HOLYNOTBAD/holydrone/docs/DIRECTORIES.md

# 目录索引

核查日期：2026-10-18。以下逐目录列出当前仓库内容；不含 Git 内部目录和会话锁文件。文件数不是采购数量。

| 路径 | 内容 | 直接文件数（不含锁文件） |
| --- | --- | --- |
| `3dp4drone/` | 机载打印件及其 CAD 原稿、材料库。 | 1 |
| `3dp4drone/balloonstatictowing/` | 静态牵引支架、气球托、衬套、碳棒示意和说明。 | 7 |
| `3dp4drone/balloontowing/` | 可转动拖曳机构与共享气球包络。 | 9 |
| `3dp4drone/balloontowing/STL_打印件/` | 仅 05/30/31/32 四个当前打印件。 | 4 |
| `3dp4drone/batteryholder/` | 共用电池托。 | 2 |
| `3dp4drone/camholder/` | 0/30/90°相机支架与网格变体。 | 8 |
| `3dp4drone/nxholder/` | NX 原支架、鲁班猫改装支架和孔位验证。 | 18 |
| `3dp4drone/receiver/` | 接收模块支架原稿与改装变体。 | 5 |
| `3dp4drone/rtk-ant holder/` | RTK 天线支架。 | 2 |
| `3dp4drone/side plate/` | 侧板和扩展模块安装板。 | 6 |
| `3dp4exp/` | 地面实验附件，非飞行器主机型。 | 0 |
| `3dp4exp/balloon dynamic holder/` | 当前为空目录，未提供可用动态气球固定模型。 | 0 |
| `3dp4exp/balloon static holder/` | 地面气球固定附件。 | 2 |
| `3dp4exp/drone takeoff stand/` | 起飞支撑件。 | 4 |
| `3dp4exp/RTK base station/` | 基站三件 STL。 | 3 |
| `demo/` | 原始爆炸视图参考视频。 | 1 |
| `docs/` | 公开说明、来源与核查记录。 | 3 |
| `docs/data/` | 配置清单、几何快照、媒体哈希与验证记录。 | 4 |
| `docs/history/` | 整理前说明的读取文本快照，保留旧路径与历史修复记录，不是有效 CAD 机型。 | 1 |
| `docs/media/` | README 展示 GIF、静态预览及素材说明。 | 7 |
| `docs/tools/` | 按 PID 连接、只读导出 CAD 网格与渲染 GIF 的脚本及说明。 | 5 |
| `fasteners/` | 紧固件外形及组合/镜像模型。 | 29 |
| `modules/` | 采购模块外形与派生装配模型。 | 8 |
| `modules/LubanCat4/` | 鲁班猫原始 STEP 及带/不带底板的派生模型。 | 3 |
| `modules/misc/` | 输入交换格式与下载来源包；其中也有主装配有效依赖。 | 6 |
| `modules/misc/antenna-sma-915-mhz-for-lara-1.snapshot.2/` | 天线 STEP/FreeCAD 原文件及截图。 | 3 |
| `modules/misc/C-RTK 2hp/` | C-RTK2Hp 原始 STEP 与有效 SLDPRT 依赖。 | 2 |
| `modules/misc/gxivision-s2m06-1.snapshot.6/` | 相机 CAD 下载快照与截图。 | 4 |
| `modules/misc/lipo-battery-2.snapshot.2/` | 电池子装配、叶子零件、渲染和贴图；有效依赖。 | 7 |
| `modules/misc/propeller-622.snapshot.2/` | 桨叶 STEP 与截图。 | 2 |
| `modules/misc/speedybee-f405-mini-bls-35a-1.snapshot.4/` | 飞控/电调原始 STEP、SLDPRT 与截图。 | 4 |
| `modules/misc/telemetry-cuav-air-link-4g-1.snapshot.3/` | Air Link 4G 原始多格式模型，当前主机型清单未启用。 | 4 |
| `plates/` | 机架板件 CAD。 | 8 |
