HOLYNOTBAD/holydrone/docs/SOURCES.md

# 来源、核查范围与待确认事项

日期：2026-10-18。此文件说明公开文档每类结论的证据边界，不把旧聊天记录或旧路径当作当前磁盘状态。

旧说明的读取文本保存在 [整理前说明快照](history/20261018-notes-before-update.txt)，包括旧路径、安装坐标与历史修复记录；只用于追溯，不作为当前生产依据。

## 已读取的仓库证据

| 来源 | 支持的内容 | 限制 |
| --- | --- | --- |
| 四个根目录主装配体 | 配置名、组件路径、压缩/可见状态、零件几何与变换 | 用 SolidWorks 2024 独立只读会话读取，未保存 CAD；不等于完成配合求解、全机碰撞或实物验证 |
| `装配版本说明.txt` | NX/鲁班猫/拖曳版本的建模历史 | 原文旧路径已按本次实际组件清单更正；历史修复记录不是本次验证结果 |
| `3dp4drone/nxholder/鲁班猫支架安装说明.txt`、`tray6_validation.txt` | 六孔支架接口、USB 朝向、底板保留与既有孔位验证 | 本次核对启用模型，未重做全部孔轴、流形、强度与打印工艺验证 |
| 两个牵引目录内说明 | 打印件用途、静态版尺寸与建模历史 | 已更正“气球未建模”、旧目录、旧暂定规格表述；采购件和制造工艺缺项仍待确认 |
| `modules/misc/` 与 `modules/LubanCat4/` 输入文件 | 外部输入 CAD 的文件级线索 | `snapshot` 文件夹名不能确定平台、作者或授权，不编造 GrabCAD 等下载链接 |
| `demo/holydrone explode.mp4` | 真实爆炸展示参考的分层展开方式 | 原片本身不能证明四种当前机型状态；新 GIF 分别读取 NX/鲁班猫实际几何 |
| 仓库六张原有 PNG/JPG | 逐张检查为天线截图、相机渲染、电池渲染/贴图、桨叶截图、飞控渲染 | 不是两种牵引版的整机实物照片；电池贴图上的标签不作为本机采购规格 |
| 维护者直接提供的规格 | 静态碳棒直径 4 mm、长度 300 mm | 本次 CAD 包围盒与之相符；没有实物测量照片或采购凭证 |

根目录检查未发现适用的 `AGENTS.md`；核查过从磁盘根目录至仓库的祖先目录及仓库内部。初始 Git 状态已有大量修改、删除、未跟踪文件，整理未覆盖或撤销这些 CAD 改动，也未提交/推送。

## CAD 配置检查

| 装配体 | 配置 | 启用组件条目数（含子装配及叶子） | 缺失的启用路径 |
| --- | --- | ---: | ---: |
| NX | 默认 | 61 | 0 |
| 鲁班猫 | 默认 | 61 | 0 |
| 静态牵引 | STATIC_TOWING_NOHOST | 63 | 0 |
| 拖曳 | GROUND_0deg | 57 | 0 |
| 拖曳 | AIRBORNE_90deg | 58 | 0 |

明细见 [assembly-components.tsv](data/assembly-components.tsv)。压缩状态原始值 `0` 为压缩，本次 `2` 为已解析；`hidden` 是包含父级状态的可见性结果。条目数包含子装配和叶子，不能作为实物件数相加。已压缩组件的缺失不在上表“启用路径”统计范围内。

`geometry-snapshot.json` 记录保存配置读取时的零件局部包围盒（米）和 SolidWorks 变换。两牵引版球体局部范围为 ±0.075 m；静态碳棒为 0.004×0.004×0.300 m；这些是 CAD 几何证据。

打开四个主装配体时错误码均为 0、警告码 32（swFileLoadWarning_NeedsRegen，需要重建）。初次提取时四份文档 `GetSaveFlag=False`；遍历并还原配置后拖曳装配在内存中 `GetSaveFlag=True`。本次未执行完整重建/配合修复，也未调用任何 CAD 保存接口；开源使用前需在工作副本中重建并核查警告。修改标记只属于专用只读会话，未据此覆盖磁盘。

## Notion 访问与待补摘要

指定页面：[holydrone 7](https://app.notion.com/p/holydrone-7-3573520427fd8005840cdcc12764cd68)。2026-10-18 在浏览器实际打开后显示“登录即可在 Hong Li 的工作空间中查看此页面”。当前没有可读正文；未绕过权限，也未把空白 HTML 壳当作页面内容。

需要由有权限的账号登录、提供公开只读页面，或导出包含正文及图片的页面资料。访问条件已在整理开始阶段告知用户。待访问后逐项补齐：

- BOM：实际品牌、版本、数量、购买来源、电池及动力规格；与装配模型差异。
- 设计方案：页面所述目标、方案选择依据与实验结构，区分历史方案和当前四机型。
- 性能：实测重量、载荷、续航、定位/牵引表现及测试条件；没有数据则保持未测。
- 调试：接线图、固件版本、参数文件、接口映射、标定流程、日志与已知问题。
- 展示：静态/可转动牵引版实物照片、拍摄来源与可公开使用的授权。

根 README 中相应段落是仓库证据整理，不是对尚不可读 Notion 页面的摘要。

## 第三方模型与许可追溯

| 输入线索 | 已知元数据 | 仍需补充 |
| --- | --- | --- |
| `LubanCat 4.STEP`、`C-RTK2Hp.STEP` | STEP 头部记录 SolidWorks 2021，作者/组织为空 | 原始发布者、下载页、版本、模型许可 |
| `ORIN NX.stp` | STEP author 字段为 `INVENTOR` | 实际作者、硬件厂商及载板版本、下载页与授权；工具名不能作署名 |
| 天线 STEP / FCStd | STEP 头部为 FreeCAD / Open CASCADE，作者为空 | 模型作者和许可；格式/工具不证明权属 |
| `Telemetry CUAV Air Link 4G.stp` | CATIA V5 导出，author/organization 为 `none` | 原始来源与许可；当前主机型清单未启用此 4G 模型 |
| 相机/飞控/桨叶 `snapshot` 包 | 保留下载包名、交换格式和截图 | 真实下载链接、原作者及适用条款；不能据文件夹猜测平台 |
| NX 支架/接收支架 CATPart 原稿 | 保留原稿和后续 SLDPRT/STL | 原设计者、转换/改装关系、是否允许再分发与改装 |
| 机架板件/电机/紧固件等 | 模型名称与当前装配引用 | 原始设计/下载来源、图纸权利、实际采购记录 |

仓库未发现 LICENSE/COPYING 等明确授权文件，本次未添加任何许可证。公开可访问不等于自由授权；应由权利人确认项目代码/文档/自制件的许可，并独立核实第三方 CAD 是否可随仓库再分发。

## 本次修改边界

新增中文 README、零件来源表、目录索引、配置/几何/哈希记录、两份 GIF 与四份 PNG、动画生成脚本、锁文件忽略规则；修正三份旧说明。未修改 CAD/STL、未重命名零件、未删除归档数据、未提交推送或发布。历史归档和缺失外部来源均明确标记，不列成当前有效机型或采购依据。
