HOLYNOTBAD/holydrone/demo/holydrone_lbc4_v1-exploded.png

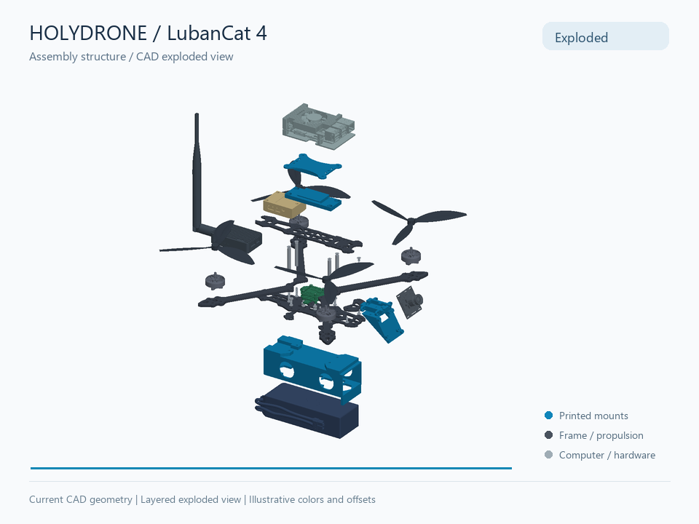
demo/holydrone_lbc4_v1-exploded.png
