HOLYNOTBAD/holydrone/demo/real/originals/holydrone_lbc4.jpg

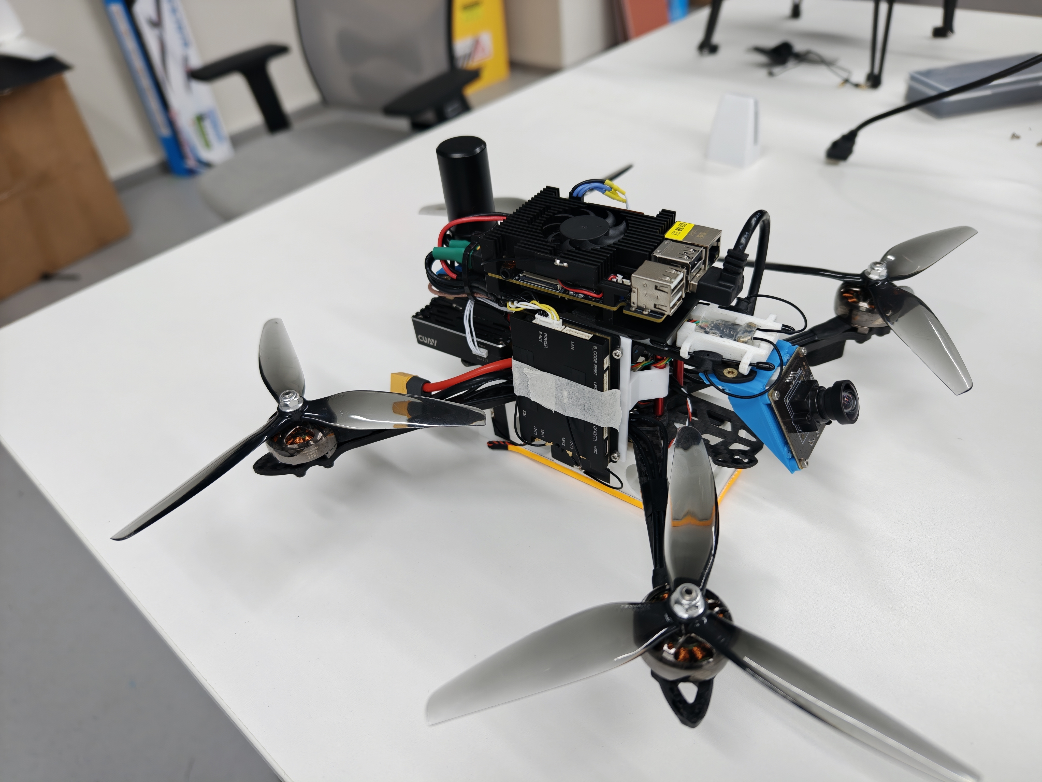
demo/real/originals/holydrone_lbc4.jpg
