HOLYNOTBAD/holydrone/demo/real/originals/holydrone_nx.png

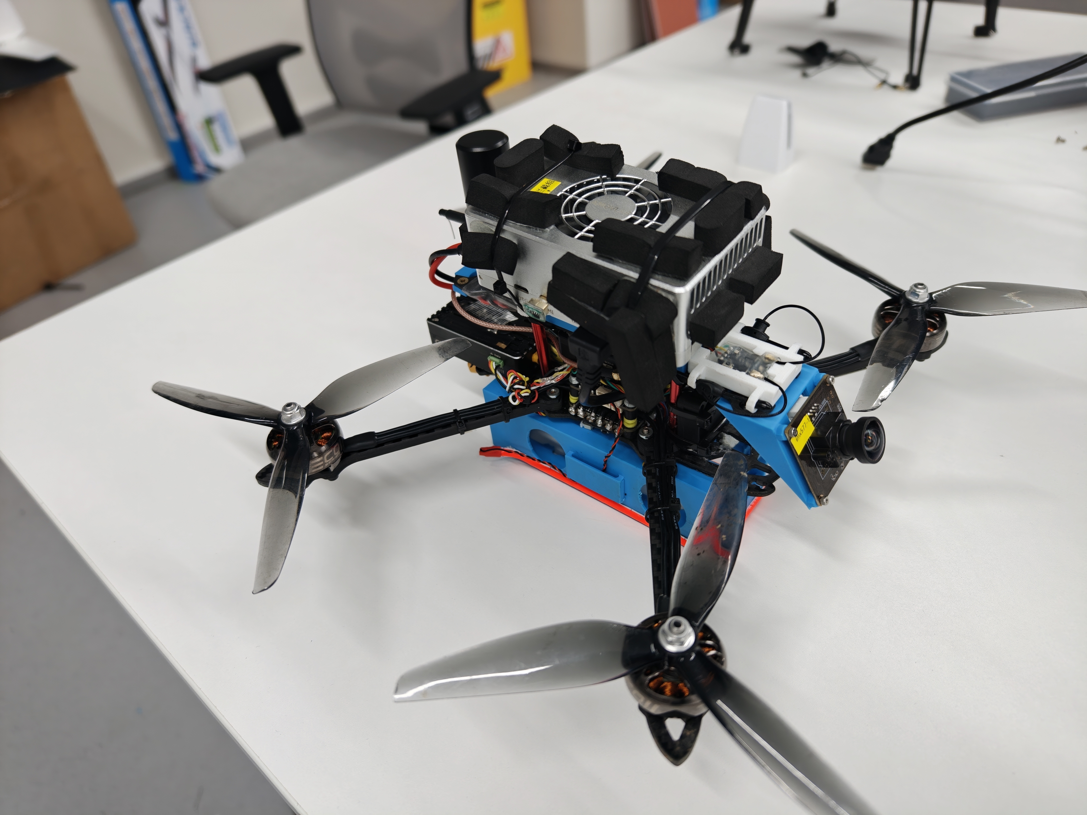
demo/real/originals/holydrone_nx.png
