HOLYNOTBAD/holydrone/demo/real/originals/holydrone_nx_darkbg.jpg

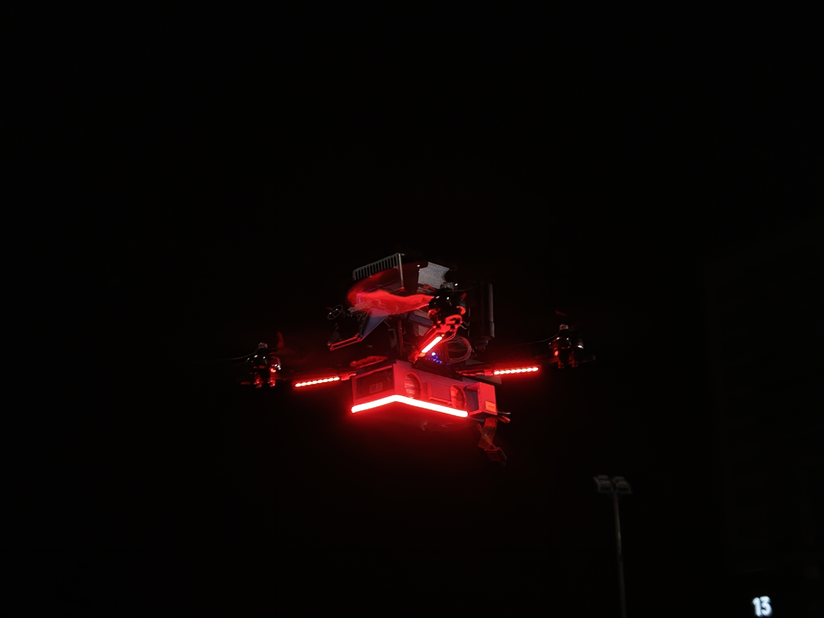
demo/real/originals/holydrone_nx_darkbg.jpg
