HOLYNOTBAD/holydrone/demo/real/originals/holydrone_static_towing.jpg

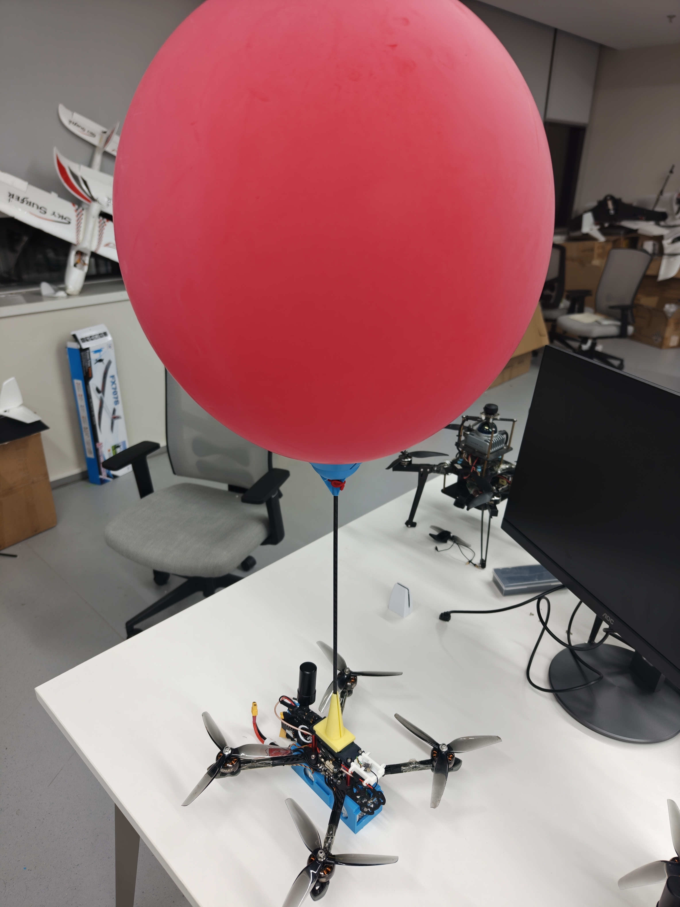
demo/real/originals/holydrone_static_towing.jpg
