HOLYNOTBAD/holydrone/Hardware/modules/misc/gxivision-s2m06-1.snapshot.6/Captura de tela 2026-01-26 100149.png

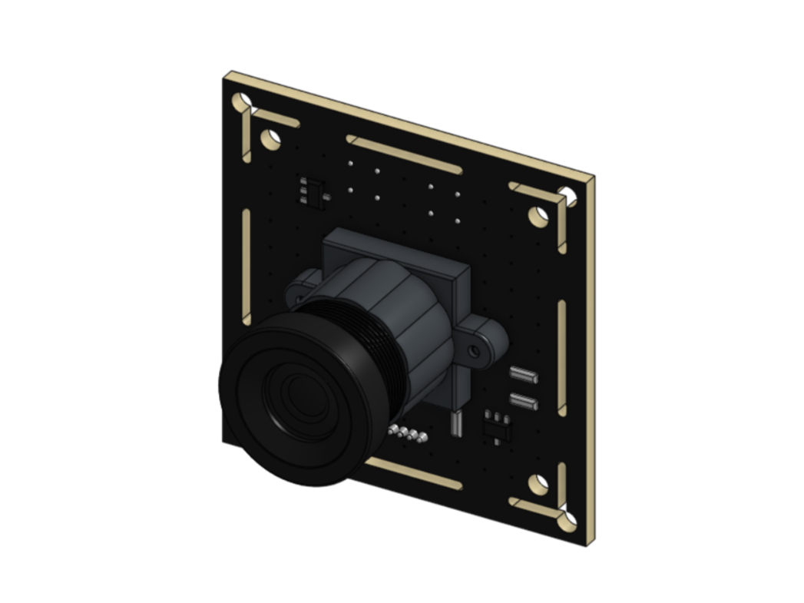
Hardware/modules/misc/gxivision-s2m06-1.snapshot.6/Captura de tela 2026-01-26 100149.png
