HOLYNOTBAD/holydrone/Hardware/modules/misc/lipo-battery-2.snapshot.2/s-l1600.png

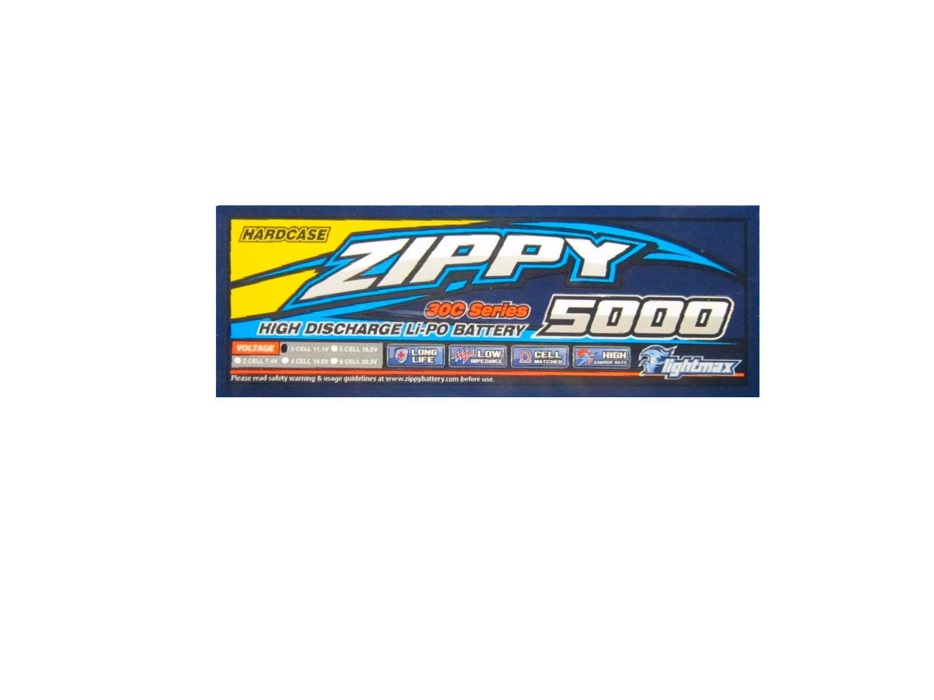
Hardware/modules/misc/lipo-battery-2.snapshot.2/s-l1600.png
