HOLYNOTBAD/holydrone/Hardware/modules/misc/propeller-622.snapshot.2/Знімок екрана 2025-10-03 111559.png

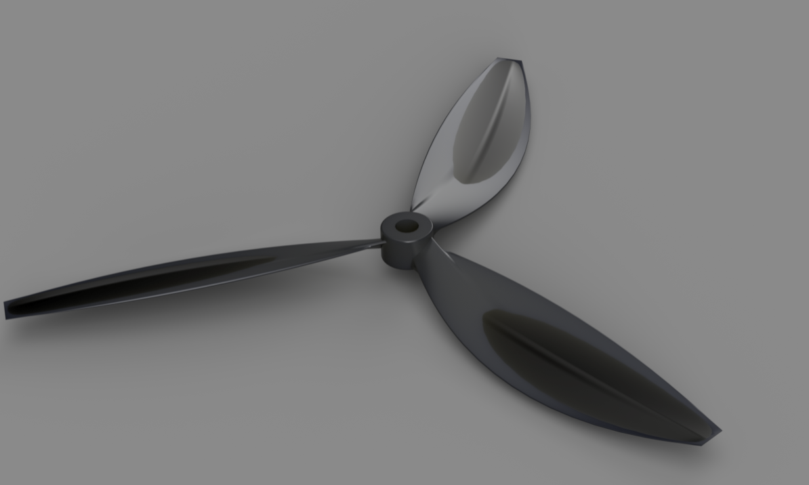
Hardware/modules/misc/propeller-622.snapshot.2/Знімок екрана 2025-10-03 111559.png
