HOLYNOTBAD/holydrone/Hardware/modules/misc/speedybee-f405-mini-bls-35a-1.snapshot.4/Captura de tela 2026-01-25 144755.png

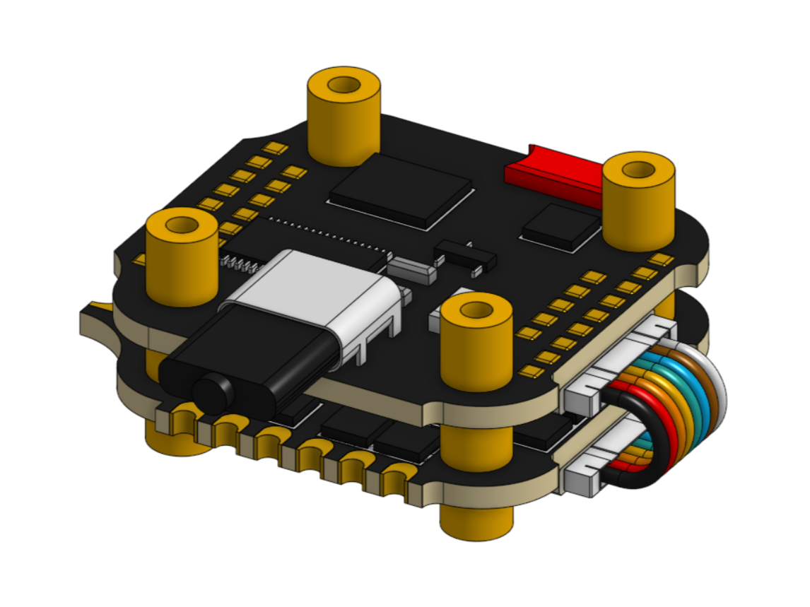
Hardware/modules/misc/speedybee-f405-mini-bls-35a-1.snapshot.4/Captura de tela 2026-01-25 144755.png
