HOLYNOTBAD/holydrone/modules/misc/antenna-sma-915-mhz-for-lara-1.snapshot.2/2025-11-23_17-32.jpg

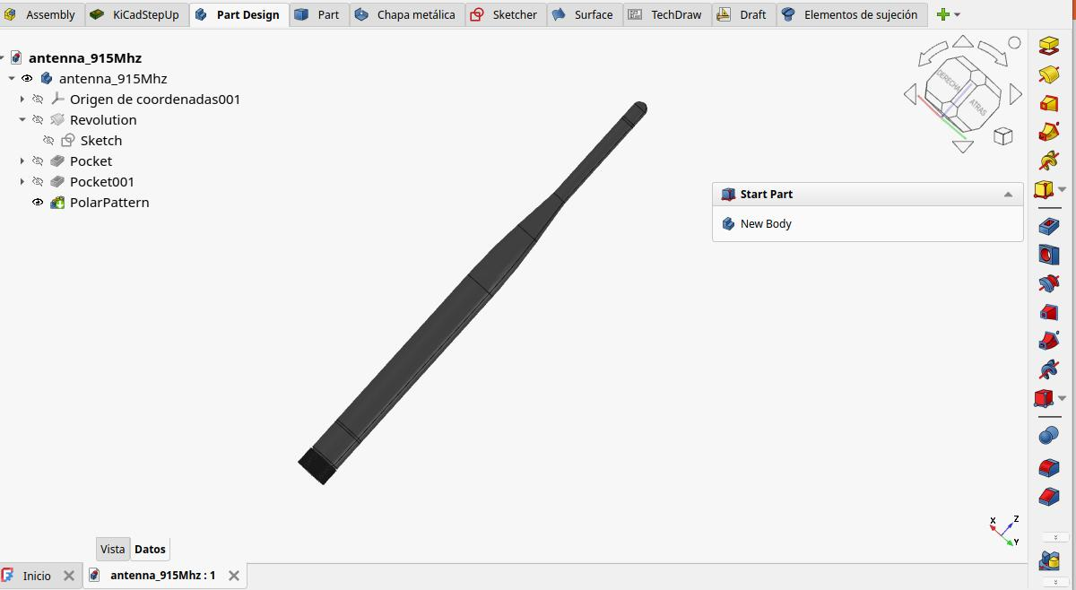
modules/misc/antenna-sma-915-mhz-for-lara-1.snapshot.2/2025-11-23_17-32.jpg
