HOLYNOTBAD/holydrone/modules/misc/lipo-battery-2.snapshot.2/renderizado.jpg

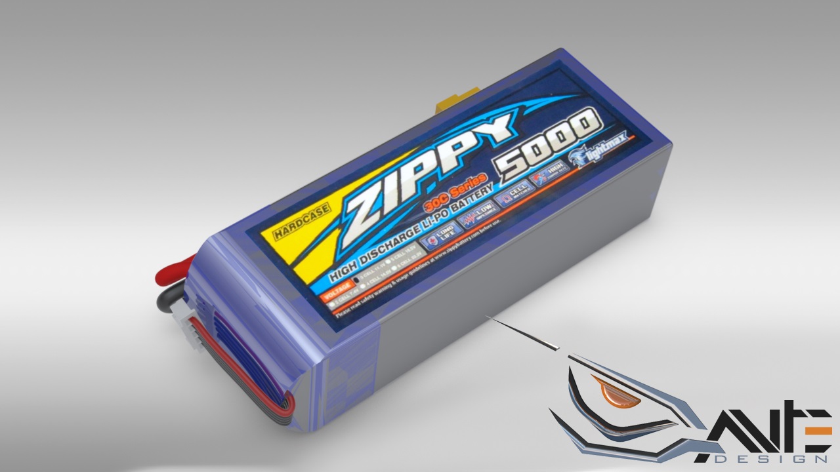
modules/misc/lipo-battery-2.snapshot.2/renderizado.jpg
