HOLYNOTBAD/holydrone/demo/bom/README.md

# BOM image sources

Original product images were retrieved from the authorized Notion BOM entries on October 19, 2026 and saved unchanged. The source pages are private and require access permission.

| BOM item | Image | Source |
| --- | --- | --- |
| 1 | [01-mark4-frame.png](01-mark4-frame.png) | [Notion entry](https://app.notion.com/p/3853520427fd80eb8708d67b02aa0914) |
| 2 | [02-emax-2807-motor.png](02-emax-2807-motor.png) | [Notion entry](https://app.notion.com/p/3853520427fd80c997d2fe212cc42cc3) |
| 3 | [03-micoair743-v2-stack.png](03-micoair743-v2-stack.png) | [Notion entry](https://app.notion.com/p/3863520427fd80e5b3b5d1053c863097) |
| 4 | [04-allspark2-orin.png](04-allspark2-orin.png) | [Notion entry](https://app.notion.com/p/3863520427fd80f0aee0de7d13960a08) |
| 5 | [05-cuav-p9-radio.png](05-cuav-p9-radio.png) | [Notion entry](https://app.notion.com/p/3863520427fd8081b237eaf9323663f4) |
| 6 | [06-elrs-receiver.png](06-elrs-receiver.png) | [Notion entry](https://app.notion.com/p/3863520427fd8022b8f5facd52861a36) |
| 7 | [07-usb-camera.png](07-usb-camera.png) | [Notion entry](https://app.notion.com/p/3863520427fd80dabec5fc4ffb251a3b) |
| 8 | [08-unnamed-item.png](08-unnamed-item.png) | [Notion entry](https://app.notion.com/p/39c3520427fd80ab800af4c0dd67ad9f) |
| 9 | [09-hqprop-7040.png](09-hqprop-7040.png) | [Notion entry](https://app.notion.com/p/3863520427fd80a888f2d6b08ec50436) |
| 10 | [10-dc-dc-converter.png](10-dc-dc-converter.png) | [Notion entry](https://app.notion.com/p/3863520427fd803482f5eda7833b36de) |
| 12 | [12-display-emulator.png](12-display-emulator.png) | [Notion entry](https://app.notion.com/p/3863520427fd8089b535e494862bcd4c) |
| 14 | [14-parachute.png](14-parachute.png) | [Notion entry](https://app.notion.com/p/3893520427fd8031a077c74d3382d327) |
| 15 | [15-cuav-rtk.png](15-cuav-rtk.png) | [Notion entry](https://app.notion.com/p/3893520427fd804b8ea0cf309360ff4a) |
| 11 | [10-dc-dc-converter.png](10-dc-dc-converter.png) | [Notion entry](https://app.notion.com/p/3863520427fd803482f5eda7833b36de); generic image shared with the 12 V entry; the 5 V entry has no image |

Item 13 (RGB LED strip and quick-connect board) has no source image. Item 8 has no name; its image advertises a USB industrial camera, but the model remains unconfirmed. The 5 V converter shares a generic product image with the 12 V entry. Product images identify appearance and do not independently verify advertised performance.
