HOLYNOTBAD/holydrone/(list of files, cad)

Other CAD files:
Hardware/Hardware.SLDASM
Hardware/modules/misc/lipo-battery-2.snapshot.2/Bateria Lipo.SLDASM
holydrone_nx_v1.SLDASM
Hardware.SLDASM
Hardware/holydrone_towing_v1.SLDASM
Hardware/holydrone_lbc4_v1.SLDASM
holydrone_v1.SLDASM
Hardware/holydrone_static_towing_v1.sldasm
holydrone_v1_NoProp.SLDASM
modules/CUAV P9 Radio.SLDASM
modules/misc/lipo-battery-2.snapshot.2/Bateria Lipo.SLDASM
3dp4drone/balloonstatictowing/static_carbon_rod_D4_L300_assumed.SLDPRT
3dp4drone/balloontowing/32_BatteryHolder_MountReady.SLDPRT
3dp4drone/balloontowing/STL_打印件/05_Balloon50_QuickTie_Ballast.stl
3dp4drone/batteryholder/batteryholder v9.sldprt
3dp4drone/camholder/camholder30deg.SLDPRT
3dp4drone/nxholder/nxholder_Part2-rk3588lbc4.STEP
3dp4drone/receiver/receiver_Part1_org.SLDPRT
3dp4drone/rtk-ant holder/rtk-ant holder.SLDPRT
3dp4drone/side plate/Side 5GmodulePlate.SLDPRT
3dp4exp/balloon static holder/balloon static holder.SLDPRT
3dp4exp/drone takeoff stand/support.SLDPRT
camholder/camhold.stl
Hardware/3dp4drone/balloonstatictowing/气球托v4 4.2mm.STL
Hardware/3dp4drone/balloontowing/11_Balloon_D50_Envelope.SLDPRT
Hardware/3dp4drone/balloontowing/STL_打印件/31_Clamp_Rounded.stl
Hardware/3dp4drone/camholder/camholder0deg.SLDPRT
Hardware/3dp4drone/nxholder/up nxholder.stl
Hardware/3dp4drone/receiver/receiver_Part1.SLDPRT
Hardware/3dp4drone/rtk-ant holder/rtk-ant holder.STL
Hardware/3dp4drone/side plate/Side Plate.SLDPRT
Hardware/3dp4exp/balloon static holder/balloon static holder.STL
Hardware/3dp4exp/drone takeoff stand/support30degree.SLDPRT
Hardware/3dp4exp/RTK base station/RTK base station prt2.stl
Hardware/modules/C-RTK2Hp.SLDPRT
Hardware/modules/LubanCat4/LubanCat4_with_bottom_tray.SLDPRT
Hardware/modules/misc/antenna-sma-915-mhz-for-lara-1.snapshot.2/antenna_915Mhz.FCStd
Hardware/modules/misc/gxivision-s2m06-1.snapshot.6/Câmera GXIVISION S2M06.sldprt
Hardware/modules/misc/Telemetry CUAV Air Link 4G.stp
Hardware/plates/TailPlate.SLDPRT
modules/LubanCat4/LubanCat4_no_bottom_tray.SLDPRT
modules/misc/C-RTK 2hp/C-RTK2Hp.STEP
modules/misc/gxivision-s2m06-1.snapshot.6/Câmera GXIVISION S2M06.step
modules/misc/lipo-battery-2.snapshot.2/Conector XT60.SLDPRT
modules/misc/speedybee-f405-mini-bls-35a-1.snapshot.4/SpeedyBee F405 Mini BLS 35A.step
modules/misc/Telemetry CUAV P9 radio.SLDPRT
modules/misc/telemetry-cuav-air-link-4g-1.snapshot.3/Telemetry CUAV Air Link 4G.SLDPRT
modules/Propeller 7inch.SLDPRT
others/Battery Pad.SLDPRT
plates/ChinPlate.SLDPRT
Simulation/holydrone_sim/gazebo/models/holydrone/meshes/Propeller 7inch.STL
3dp4drone/balloonstatictowing/bolloon holder.SLDPRT
3dp4drone/balloontowing/05_Balloon50_QuickTie_Ballast.SLDPRT
3dp4drone/balloontowing/STL_打印件/30_Hinge_RootFillets.stl
3dp4drone/camholder/camholder90deg.SLDPRT
3dp4drone/nxholder/nxholder_Part1.SLDPRT
3dp4drone/receiver/receiver holder.stl
3dp4drone/side plate/Side Plate.SLDPRT
camholder/camholder30deg.SLDPRT
Hardware/3dp4drone/balloonstatictowing/balloon_cup_v4_4p2_imported.SLDPRT
Hardware/3dp4drone/balloontowing/03_CarbonTube_6x300_BoreAssumed.SLDPRT
Hardware/3dp4drone/balloontowing/STL_打印件/32_BatteryHolder_MountReady.stl
Hardware/3dp4drone/nxholder/down nxholder.stl
Hardware/3dp4drone/side plate/Side MiddlePlate.SLDPRT
Hardware/3dp4exp/RTK base station/RTK base station prt1.STL
Hardware/modules/misc/ORIN NX.stp
Hardware/modules/ORIN NX.SLDPRT
Hardware/plates/Top Plate.SLDPRT
modules/LubanCat4/LubanCat 4.STEP
modules/misc/lipo-battery-2.snapshot.2/Conector.SLDPRT
modules/misc/Telemetry CUAV P9 radio 915MHz Ant.SLDPRT
modules/SpeedyBee F405 Mini BLS 35A.sldprt
plates/ArmPlate.SLDPRT
Simulation/holydrone_sim/gazebo/models/holydrone/meshes/holydrone_v1.STL
3dp4drone/balloonstatictowing/static_adapter_OD6_ID4p2_L71p5.SLDPRT
3dp4drone/balloontowing/12_CottonLine_D0p18_L500.SLDPRT
3dp4drone/camholder/camholder90degv2.STL
3dp4drone/nxholder/balloon plate.SLDPRT
3dp4drone/side plate/Side MiddlePlate.SLDPRT
camholder/camholder90deg.SLDPRT
Hardware/3dp4drone/balloontowing/06_Pivot_Sleeve_4x3p2_L12p6.SLDPRT
Hardware/3dp4drone/nxholder/nxholder_Part3.SLDPRT
Hardware/3dp4exp/RTK base station/RTK base station prt3.stl
modules/Emax ECO II 2306.SLDPRT
modules/misc/lipo-battery-2.snapshot.2/Nucleo de la bateria.SLDPRT
modules/misc/propeller.step
plates/BottomPlate.SLDPRT
3dp4drone/balloontowing/31_Clamp_Rounded.SLDPRT
3dp4drone/camholder/camholder0deg.SLDPRT
3dp4drone/nxholder/nxholder_Part2.SLDPRT
Hardware/3dp4drone/nxholder/nxholder_Part2-rk3588lbc4_original.SLDPRT
modules/Câmera GXIVISION S2M06.sldprt
modules/misc/antenna_915Mhz-antenna_915Mhz.step
modules/misc/lipo-battery-2.snapshot.2/Funda de la bateria.SLDPRT
plates/GEPRC Mk4 7in Arms.SLDPRT
3dp4drone/balloontowing/30_Hinge_RootFillets.SLDPRT
3dp4drone/camholder/camholder30degv2.STL
3dp4drone/nxholder/bolloon holder.stl
plates/Top Plate.SLDPRT
3dp4drone/camholder/30du.stl
3dp4drone/nxholder/midd nxholder.stl
modules/ORIN NX.SLDPRT
plates/Tail Plate.SLDPRT
3dp4drone/camholder/15du.stl
plates/Cam Plates.SLDPRT
3dp4drone/camholder/0du.stl
3dp4drone/camholder/45du.stl
3dp4drone/batteryholder/batteryholder v9.STL
3dp4drone/camholder/0du.CATPart
3dp4drone/camholder/15du.CATPart
3dp4drone/camholder/45du.CATPart
3dp4drone/camholder/Part1.CATPart
3dp4drone/nxholder/Part2.CATPart
3dp4drone/nxholder/Part3.CATPart
3dp4drone/nxholder/balloon plate.STL
3dp4drone/nxholder/nxholder_Part2-rk3588lbc4.SLDPRT
3dp4drone/nxholder/nxholder_Part2-rk3588lbc4.STL
3dp4drone/receiver/Part1_org.CATPart
3dp4drone/side plate/Side 5GmodulePlate.STL
3dp4drone/side plate/Side Middle Plate.STL
3dp4drone/side plate/Side Plate.stl
3dp4exp/drone takeoff stand/support.STL
Hardware/3dp4drone/camholder/camholder0deg.STL
Hardware/3dp4drone/nxholder/Part1.CATPart
Hardware/3dp4drone/nxholder/bolloon holder.CATPart
Hardware/3dp4drone/receiver/Part1.CATPart
Hardware/3dp4exp/drone takeoff stand/support30degree.STL
Hardware/fasteners/M3 Insert(Mirror)(Mirror).SLDPRT
Hardware/fasteners/M3 Insert.SLDPRT
Hardware/fasteners/M3x10 Cap Screw (1)(Mirror)(Mirror).SLDPRT
Hardware/fasteners/M3x14 Cap Screw(Mirror) (1).SLDPRT
Hardware/fasteners/M3x14 Cap Screw(Mirror)(Mirror).SLDPRT
Hardware/fasteners/M3x8 Flush Screw x4.SLDPRT
Hardware/fasteners/Stack M3x25 Cap Screw_Nut x4.SLDASM
Hardware/fasteners/Standoff M3x37.SLDPRT
Hardware/modules/misc/gxivision-s2m06-1.snapshot.6/Câmera GXIVISION S2M06.x_t
camholder/camholder30deg.STL
camholder/camholder90deg.STL
fasteners/M3 Insert(Mirror) (1).SLDPRT
fasteners/M3 Insert(Mirror)(Mirror).SLDPRT
fasteners/M3 Insert(Mirror).SLDPRT
fasteners/M3 Insert.SLDPRT
fasteners/M3 Nut v1(Mirror) (1).SLDPRT
fasteners/M3 Nut v1(Mirror)(Mirror).SLDPRT
fasteners/M3 Nut v1(Mirror).SLDPRT
fasteners/M3 Nut v1.SLDPRT
fasteners/M3 Threaded Sheet Inserts x4.SLDASM
fasteners/M3x10 Cap Screw (1)(Mirror) (1).SLDPRT
fasteners/M3x10 Cap Screw (1)(Mirror)(Mirror).SLDPRT
fasteners/M3x10 Cap Screw (1)(Mirror).SLDPRT
fasteners/M3x10 Cap Screw (1).SLDPRT
fasteners/M3x10 Cap Screw x4.SLDASM
fasteners/M3x14 Cap Screw x4.SLDASM
fasteners/M3x14 Cap Screw(Mirror) (1).SLDPRT
fasteners/M3x14 Cap Screw(Mirror)(Mirror).SLDPRT
fasteners/M3x14 Cap Screw(Mirror).SLDPRT
fasteners/M3x14 Cap Screw.SLDPRT
fasteners/M3x25 Cap Screw (2)(Mirror) (1).SLDPRT
fasteners/M3x25 Cap Screw (2)(Mirror)(Mirror).SLDPRT
fasteners/M3x25 Cap Screw (2)(Mirror).SLDPRT
fasteners/M3x25 Cap Screw (2).SLDPRT
fasteners/M3x6 Flush Screw x8.SLDPRT
fasteners/M3x8 Flush Screw x4.SLDPRT
fasteners/Stack M3x25 Cap Screw_Nut x4.SLDASM
fasteners/Standoff M3x25.SLDPRT
fasteners/Standoff M3x37.SLDPRT
fasteners/Standoff M3x44.SLDPRT
modules/misc/C-RTK 2hp/C-RTK2Hp.SLDPRT
modules/misc/speedybee-f405-mini-bls-35a-1.snapshot.4/SpeedyBee F405 Mini BLS 35A.sldprt
modules/misc/speedybee-f405-mini-bls-35a-1.snapshot.4/SpeedyBee F405 Mini BLS 35A.x_t
modules/misc/telemetry-cuav-air-link-4g-1.snapshot.3/Telemetry CUAV Air Link 4G.CATPart
modules/misc/telemetry-cuav-air-link-4g-1.snapshot.3/Telemetry CUAV Air Link 4G.igs
