HOLYNOTBAD/holydrone/Params/1111 lite identification.params

2	1	BAT1_A_PER_V	40.000000000000000000	9
2	1	BAT1_CAPACITY	-1.000000000000000000	9
2	1	BAT1_I_CHANNEL	-1	6
2	1	BAT1_I_OVERWRITE	0.000000000000000000	9
2	1	BAT1_N_CELLS	4	6
2	1	BAT1_R_INTERNAL	-1.000000000000000000	9
2	1	BAT1_SOURCE	0	6
2	1	BAT1_V_CHANNEL	-1	6
2	1	BAT1_V_CHARGED	4.199999809265136719	9
2	1	BAT1_V_DIV	21.120000839233398438	9
2	1	BAT1_V_EMPTY	3.200000047683715820	9
2	1	BAT_AVRG_CURRENT	15.000000000000000000	9
2	1	BAT_CRIT_THR	0.070000000298023224	9
2	1	BAT_EMERGEN_THR	0.050000000745058060	9
2	1	BAT_LOW_THR	0.150000005960464478	9
2	1	BAT_V_OFFS_CURR	0.000000000000000000	9
2	1	CA_AIRFRAME	0	6
2	1	CA_ROTOR0_AX	0.000000000000000000	9
2	1	CA_ROTOR0_AY	0.000000000000000000	9
2	1	CA_ROTOR0_AZ	-1.000000000000000000	9
2	1	CA_ROTOR0_CT	6.500000000000000000	9
2	1	CA_ROTOR0_KM	-0.050000000745058060	9
2	1	CA_ROTOR0_PX	1.000000000000000000	9
2	1	CA_ROTOR0_PY	1.000000000000000000	9
2	1	CA_ROTOR0_PZ	0.000000000000000000	9
2	1	CA_ROTOR10_AX	0.000000000000000000	9
2	1	CA_ROTOR10_AY	0.000000000000000000	9
2	1	CA_ROTOR10_AZ	-1.000000000000000000	9
2	1	CA_ROTOR10_CT	6.500000000000000000	9
2	1	CA_ROTOR10_KM	0.050000000745058060	9
2	1	CA_ROTOR10_PX	0.000000000000000000	9
2	1	CA_ROTOR10_PY	0.000000000000000000	9
2	1	CA_ROTOR10_PZ	0.000000000000000000	9
2	1	CA_ROTOR11_AX	0.000000000000000000	9
2	1	CA_ROTOR11_AY	0.000000000000000000	9
2	1	CA_ROTOR11_AZ	-1.000000000000000000	9
2	1	CA_ROTOR11_CT	6.500000000000000000	9
2	1	CA_ROTOR11_KM	0.050000000745058060	9
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
2	1	PWM_MAIN_MIN3	1000	6
2	1	PWM_MAIN_MIN4	1000	6
2	1	PWM_MAIN_MIN5	1000	6
2	1	PWM_MAIN_MIN6	1000	6
2	1	PWM_MAIN_MIN7	1000	6
2	1	PWM_MAIN_MIN8	1000	6
2	1	PWM_MAIN_MIN9	1000	6
2	1	PWM_MAIN_TIM0	-4	6
2	1	PWM_MAIN_TIM1	400	6
2	1	PWM_MAIN_TIM2	400	6
2	1	PWM_MAIN_TIM3	400	6
2	1	SYS_AUTOSTART	4001	6
