HOLYNOTBAD/holydrone/Params/0924.params

1	1	BAT1_A_PER_V	40.000000000000000000	9
1	1	BAT1_CAPACITY	-1.000000000000000000	9
1	1	BAT1_I_CHANNEL	-1	6
1	1	BAT1_I_OVERWRITE	0.000000000000000000	9
1	1	BAT1_N_CELLS	4	6
1	1	BAT1_R_INTERNAL	-1.000000000000000000	9
1	1	BAT1_SOURCE	0	6
1	1	BAT1_V_CHANNEL	-1	6
1	1	BAT1_V_CHARGED	4.199999809265136719	9
1	1	BAT1_V_DIV	21.120000839233398438	9
1	1	BAT1_V_EMPTY	3.200000047683715820	9
1	1	BAT_AVRG_CURRENT	15.000000000000000000	9
1	1	BAT_CRIT_THR	0.070000000298023224	9
1	1	BAT_EMERGEN_THR	0.050000000745058060	9
1	1	BAT_LOW_THR	0.150000005960464478	9
1	1	BAT_V_OFFS_CURR	0.000000000000000000	9
1	1	CA_AIRFRAME	0	6
1	1	CA_ROTOR0_AX	0.000000000000000000	9
1	1	CA_ROTOR0_AY	0.000000000000000000	9
1	1	CA_ROTOR0_AZ	-1.000000000000000000	9
1	1	CA_ROTOR0_CT	6.500000000000000000	9
1	1	CA_ROTOR0_KM	-0.050000000745058060	9
1	1	CA_ROTOR0_PX	1.000000000000000000	9
1	1	CA_ROTOR0_PY	1.000000000000000000	9
1	1	CA_ROTOR0_PZ	0.000000000000000000	9
1	1	CA_ROTOR10_AX	0.000000000000000000	9
1	1	CA_ROTOR10_AY	0.000000000000000000	9
1	1	CA_ROTOR10_AZ	-1.000000000000000000	9
1	1	CA_ROTOR10_CT	6.500000000000000000	9
1	1	CA_ROTOR10_KM	0.050000000745058060	9
1	1	CA_ROTOR10_PX	0.000000000000000000	9
1	1	CA_ROTOR10_PY	0.000000000000000000	9
1	1	CA_ROTOR10_PZ	0.000000000000000000	9
1	1	CA_ROTOR11_AX	0.000000000000000000	9
1	1	CA_ROTOR11_AY	0.000000000000000000	9
1	1	CA_ROTOR11_AZ	-1.000000000000000000	9
1	1	CA_ROTOR11_CT	6.500000000000000000	9
1	1	CA_ROTOR11_KM	0.050000000745058060	9
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
1	1	PWM_MAIN_DIS7	1000	6
1	1	PWM_MAIN_DIS8	1000	6
1	1	PWM_MAIN_DIS9	1000	6
1	1	PWM_MAIN_FAIL1	-1	6
1	1	PWM_MAIN_FAIL10	-1	6
1	1	PWM_MAIN_FAIL2	-1	6
1	1	PWM_MAIN_FAIL3	-1	6
1	1	PWM_MAIN_FAIL4	-1	6
1	1	PWM_MAIN_FAIL5	-1	6
1	1	PWM_MAIN_FAIL6	-1	6
1	1	PWM_MAIN_FAIL7	-1	6
1	1	PWM_MAIN_FAIL8	-1	6
1	1	PWM_MAIN_FAIL9	-1	6
1	1	PWM_MAIN_FUNC1	104	6
1	1	PWM_MAIN_FUNC10	0	6
1	1	PWM_MAIN_FUNC2	101	6
1	1	PWM_MAIN_FUNC3	102	6
1	1	PWM_MAIN_FUNC4	103	6
1	1	PWM_MAIN_FUNC5	0	6
1	1	PWM_MAIN_FUNC6	0	6
1	1	PWM_MAIN_FUNC7	0	6
1	1	PWM_MAIN_FUNC8	0	6
1	1	PWM_MAIN_FUNC9	0	6
1	1	PWM_MAIN_MAX1	2000	6
1	1	PWM_MAIN_MAX10	2000	6
1	1	PWM_MAIN_MAX2	2000	6
1	1	PWM_MAIN_MAX3	2000	6
1	1	PWM_MAIN_MAX4	2000	6
1	1	PWM_MAIN_MAX5	2000	6
1	1	PWM_MAIN_MAX6	2000	6
1	1	PWM_MAIN_MAX7	2000	6
1	1	PWM_MAIN_MAX8	2000	6
1	1	PWM_MAIN_MAX9	2000	6
1	1	PWM_MAIN_MIN1	1000	6
1	1	PWM_MAIN_MIN10	1000	6
1	1	PWM_MAIN_MIN2	1000	6
1	1	PWM_MAIN_MIN3	1000	6
1	1	PWM_MAIN_MIN4	1000	6
1	1	PWM_MAIN_MIN5	1000	6
1	1	PWM_MAIN_MIN6	1000	6
1	1	PWM_MAIN_MIN7	1000	6
1	1	PWM_MAIN_MIN8	1000	6
1	1	PWM_MAIN_MIN9	1000	6
1	1	PWM_MAIN_TIM0	-4	6
1	1	PWM_MAIN_TIM1	400	6
1	1	PWM_MAIN_TIM2	400	6
1	1	PWM_MAIN_TIM3	400	6
1	1	SYS_AUTOSTART	4001	6
