HOLYNOTBAD/holydrone/Simulation/holydrone_sim/control_interception/holydrone/simulation/isb_nmpc_sim_outdoor_5ms_30degree.yaml

# 30-degree, 5 m/s candidate; repeat validation after simulator cleanup.
control_rate: 50.0
target_dropout_hold_sec: 0.15
hover_thrust: 0.30
hover_acceleration: 10.0

Q_velocity: 550
Q_speed: 25
Q_perception_u: 1800
Q_perception_v: 900
Q_image_rate_u: 1200
Q_image_rate_v: 1000
Q_image_rate_z: 1000
Q_terminal_line: 400
Q_terminal_vis_u: 25
Q_terminal_vis_v: 25

R_thrust: 4.0
R_roll: 75
R_pitch: 50
R_yaw: 120
R_speed_delta: 80
R_slack_u: 1500
R_slack_v: 2000

state_cost_exponential: 0.0
input_cost_exponential: 0.0
max_invalid_retries: 5
max_zero_control_retries: 5

max_bodyrate_x: 0.9
max_bodyrate_y: 1.2
max_bodyrate_z: 0.5
max_roll_angle_deg: 50.0
min_thrust: 0.0
max_thrust: 50.0

min_intercept_speed: 0.8
intercept_speed: 5.0
los_speed_schedule_kh: 10.0
los_speed_schedule_kv: 12.0
max_initial_intercept_speed: 1.5
max_delta_intercept_speed: 0.6
min_solver_range: 1.0
nominal_target_range: 6.0

align_los_theta_to_image_bounds: true
image_bound_margin: 0.35
los_theta_max: 0.461799

print_info: true
