HOLYNOTBAD/holydrone/Simulation/holydrone_sim/camera/camera_params_usb_yahbom_30degree.yaml

camera:
  video_resource: 0  # /dev/video0; may also be a /dev/v4l/by-id/... path
  img_width: 640
  img_height: 480
  fx: 369
  fy: 369
  framerate: 30
  pixel_format: "mjpeg"
  cx: 320
  cy: 240
  img_f: 369       # Yahboom 2.8mm lens, about 81.8 deg H / 66 deg V FOV at 640x480
  distortion_coeffs: [0.0, 0.0, 0.0, 0.0]
  # Camera RDF -> Body FLU. Positive 30 degrees means the optical axis points upward.
  R_cam_body: [0.0, 0.5, 0.866025404, -1.0, 0.0, 0.0, 0.0, -0.866025404, 0.5]
  p_B_C: [0.095, 0.0, 0.0]
  q_B_C: [0.612372436, -0.353553391, 0.353553391, -0.612372436]  # 相机 RDF -> 机体 FLU [w x y z]
  img_distance: 20
  time_offset: 0.0

  usb_cam_driver:
    video_device: "/dev/video0"
    image_width: 640
    image_height: 480
    framerate: 30
    pixel_format: "mjpeg"
    io_method: "mmap"
    camera_name: "camera"
    camera_frame_id: "camera"

Debug:
  is_show_image: true
  is_show_rgb: false
  is_show_hsv: false
  is_show_bbx: false   # det.cpp; RViz still receives /yolo/image_annotated
  det_conf_threshold: 0.80
  is_show_3D_estimation: true
