HOLYNOTBAD/holydrone/(commit log)

2026-10-02 Update drone CAD models and support parts
2026-10-18 Organize four drone variants, printable parts, and project documentation
2026-10-19 Update README BOM from verified Notion records
2026-10-19 Add Notion product images to README BOM
2026-10-19 Add static CAD previews for towing variants and simplify README
2026-10-19 Make towing tether visible in CAD preview
2026-10-19 Add contributor acknowledgments and remove trailing BOM note
