HOLYNOTBAD/holydrone/(notices)

Notices in the files:
README.md:
GPL v3 license
